edonD/sky130-comparator/plots/progress.png

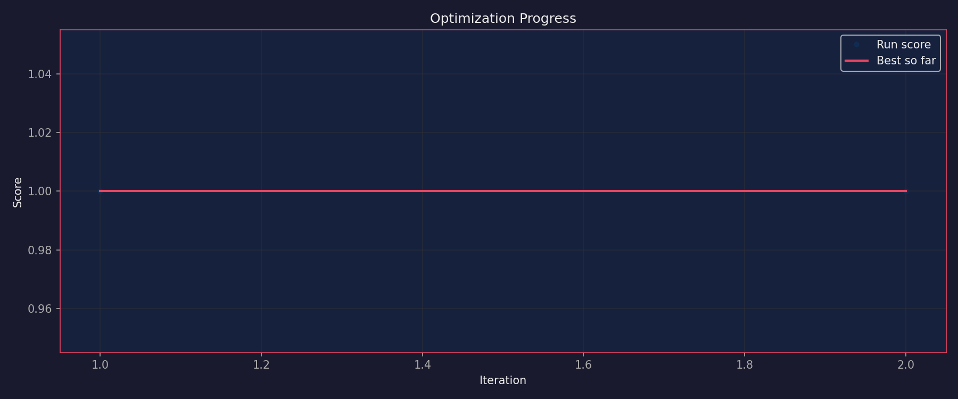
plots/progress.png
