edonD/sky130-comparator/(commit log)

2026-03-14 Initial project setup: SKY130 StrongARM comparator design framework
    - Parametric SPICE netlist (design.cir) with PVT placeholders
    - Simulation/validation utilities (evaluate.py): PVT sweep (30 corners), Monte Carlo (200 samples, 4.5σ)
    - Specs: offset < 5mV, rise-time delay < 100ns (worst-case PVT + MC)
    - No built-in optimizer — agent chooses its own (Bayesian, PSO, CMA-ES, etc.)
    - Design review discipline: waveform checks, operating point verification, anti-benchmaxxing rules
    [parameters.csv, results.tsv]
2026-03-14 Validated StrongARM comparator: score 1.00, all specs met with margin
    Design: Classic StrongARM latch with Win=50u, Lin=1.0u, Llat=0.5u
    Key insight: Longer latch channel length (0.5um) eliminates systematic PVT offset
    Results (worst-case across 30 PVT + 200-sample MC at 4.5sigma):
    - Offset: 2.32 mV (spec < 5 mV, margin 53.7%)
    - Delay: 11.83 ns (spec < 100 ns, margin 88.2%)
    - PVT: ALL 30 corners PASS
    - Monte Carlo: offset mean=0.52mV, std=0.40mV, 4.5sigma=2.32mV PASS
    [best_parameters.csv, results.tsv]
2026-03-14 Update README: combined PVT+MC verification and area trade study
    - Verified MC at worst PVT corner (ss/-40/1.2V): all pass, delay 4.5σ = 12.29ns
    - Added area vs margin trade study showing Win=50 is robust choice
    - Documented Win=35 alternative for area-constrained designs
2026-03-14 Add max clock frequency characterization to README
    Tested at ss/-40/1.2V (worst corner):
    - 10 MHz: PASS (delay ~11ns vs 50ns eval window)
    - 20 MHz: PASS (delay ~11ns vs 25ns eval window)
    - 50 MHz: FAIL (10ns eval < 11ns regeneration time)
2026-03-14 Improved design: Wlat 5->1um, 23% faster delay, 12% lower power
    Key finding: smaller latch width (1um vs 5um) with L=0.5um maintained
    reduces parasitic capacitance for faster regeneration.
    Results (worst-case PVT + MC 4.5sigma):
    - Offset: 2.32 mV (unchanged, 53.7% margin)
    - Delay: 9.13 ns (was 11.83 ns, now 90.9% margin)
    - Power: ~8.8 uW nominal (was ~10 uW)
    - MC: PASS
    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
    [best_parameters.csv, results.tsv]
2026-03-14 Update waveform plots for improved Wlat=1 design
    Both nominal and worst-case waveforms show clean StrongARM behavior
    with sharper transitions from reduced latch parasitic capacitance.
2026-03-14 Optimize tail: Ltail 0.5->0.15um, 7% lower power, slightly faster
    Shorter tail channel provides more current with less gate area.
    No impact on offset (tail L doesn't affect latch symmetry).
    - Delay: 8.97 ns (was 9.13 ns, 91.0% margin)
    - Power: ~8.2 uW nominal (was ~8.8 uW)
    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
    [best_parameters.csv, results.tsv]
2026-03-14 Improve offset margin: Win 50->60, right-size tail Wtail 25->5
    - MC offset improved from 2.32mV to 2.11mV at 4.5σ (58% margin vs 54%)
    - Tail was massively over-provisioned (W/L=167); sweep showed Wtail=5 adds only 0.5ns delay
    - Reset PMOS reduced from 3 to 2μm
    - All 30 PVT corners pass, 200 MC samples pass
    - Verified with waveform plots and swap test
    [best_parameters.csv, results.tsv]
2026-03-14 Increase Win 60->70: offset margin 58->61%, faster delay
    - MC offset improved from 2.11mV to 1.96mV at 4.5σ (61% margin)
    - PVT worst delay slightly improved: 9.21->9.10ns
    - Power increases 9.25->10.73μW (acceptable for better robustness)
    - Area increases 126->146μm² (larger input pair for offset)
    - Swap test verified, waveforms clean
    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
    [best_parameters.csv, results.tsv]
2026-03-14 Optimize latch+tail: Wlat 1->0.5, Wtail 5->8, 6.4% faster delay
    - Worst PVT delay improved from 9.10ns to 8.52ns (91.5% margin)
    - Smaller latch (0.5um) reduces parasitic capacitance at output nodes
    - Slightly larger tail (8um) provides more steering current
    - MC offset unchanged at 1.96mV (same W×L=70)
    - Systematic sweep showed Wlat=0.5 doesn't reintroduce PVT offset
    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
    [best_parameters.csv, results.tsv]
2026-03-14 Add operating point analysis and design exploration scripts
    - DC OP analysis verifies transistor operating regions
    - Input pair overdrive Vgs-Vth = 0.34V (adequate)
    - Latch devices in saturation at metastable point
    - Tail/input pair in triode post-evaluation (normal for StrongARM)
    - Added asymmetric latch and tail sweep explorations
2026-03-14 Major: LVT input pair reduces worst delay 8.52->1.64ns (5.2x faster)
    Switched input differential pair from sky130_fd_pr__nfet_01v8 to
    sky130_fd_pr__nfet_01v8_lvt (low-Vth NMOS). The ~100mV lower threshold
    voltage dramatically improves headroom at 1.2V supply:
    - Worst PVT delay: 8.52ns -> 1.64ns (5.2x improvement)
    - Delay margin: 91.5% -> 98.4%
    - MC offset unchanged: 1.96mV at 4.5σ (61% margin)
    - PVT offset: 0.01mV at all 30 corners (unchanged)
    - Power: 10.69 -> 12.05 μW (+13%, acceptable for LVT)
    - Max clock at worst corner: ~30MHz -> >150MHz
    All 30 PVT corners pass, 200 MC samples pass.
    Swap test verified, waveforms clean.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
    [results.tsv]
2026-03-14 Verify worst-corner MC and add power analysis
    - 100 MC samples at ss/-40/1.2V: all pass, delay=1.64ns
    - Power analysis shows it's dominated by input pair capacitance
    - Reducing Wtail/Wrst doesn't save power (11.8-12.3μW range)
    - No meaningful power optimization without reducing Win
